isDerek/Plug_HW_MCUBoard/纸板 PHOTO/纸板 PHOTO - P18-001_Socket Sharing_v1.0 ( MCU_Board_LPC54606 )_Derek Zhu_20171227.jpg

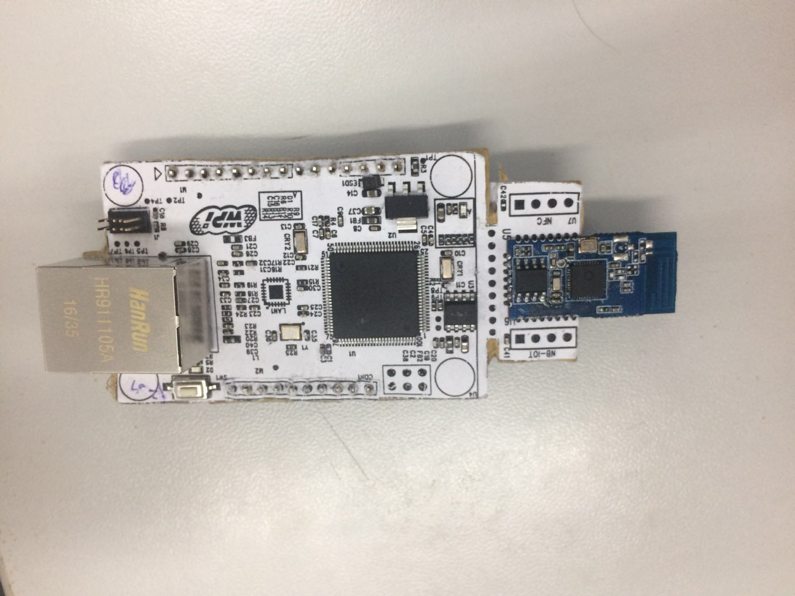
纸板 PHOTO/纸板 PHOTO - P18-001_Socket Sharing_v1.0 ( MCU_Board_LPC54606 )_Derek Zhu_20171227.jpg
