isDerek/Plug_HW_MCUBoard/方案设计 PPT/方案设计 PPT -P18-001 Oscar-Socket Sharing_v1.2_Derek Zhu_20180622.pptx

方案设计 PPT

P18-001 Socket Sharing

By Derek Zhu & Jeff Lu
2018.06.22

## Agenda

1. Version History
2. Block Diagram
3. Function Description
4. Schedule

## 1. Version History

1. 2018.02.27 - V1.0 Initial, By Derek Zhu
2. 2018.03.23 - V1.1 修改 Schedule, By Derek Zhu
3. 2018.06.22 –V1.2 修改 Schedule，By Derek Zhu

## Slide 4

2. Block Diagram – 2018.6.22

220V

交流输入

PE

N

L

继电器

Fuse

插座

16 路 IO

MCU
LPC54606

GPRS 模块

交流转直流模块

低压差线性稳压器
NCP1117ST33T3G

扩展 I2C 接口

以太网 IC
LAN8720A

5V

3.3V

网口
RJ45

JTAG
调试接口

世平提供

世平暫不提供

## Slide 5

3. Function Description – 2018.3.23

功能描述:
1. 该方案是带有联网控制，16 路 IO 控制等功能的共享插座
2. 通过以太网连接云端，可以实现微信控制插座开关和收费
3. 可以通过设备管控系统实现 OTA
4. 16 路独立过流保护

## Slide 6

4. Schedule – 2018.6.22

（1）2017.12.11 - 2017.01.21 完成 MCU Board 硬件部分
（2）2018.01.21 - 2018.02.23 调试完相关模块的驱动
（3）2018.02.26 - 2018.03.02 实现固件的基本功能
（4）2018.03.05 - 2018.04.20 完成 Power Board 硬件部分
（5）2018.04.23 - 2018.05.14 整机联调，实现 Demo 板
(6) 2018.05.15 - 2018.06.08 整机通过传导辐射
(7) 2018.06.11 - 2018.06.22 准备物料
(8) 2018.06.25 - 2018.07.06 完成第二版电源板的原理图、布局、布线
(9) 2018.07.09– 2018.07.13 完成第二版电源板的贴片、调试完 GPRS 模块

颜色说明：黑色 = On Schedule；红色 = Delay；蓝色 = 提前完成；灰色 = 待执行

## Slide 7

4. Schedule – 2018.6.11

（1） 2017.12.11 - 2017.12.25 完成 MCU 板的原理图设计及 Layout
（2） 2017.12.25 - 2018.01.07 导出 Gerber ，发出去洗板
（3） 2018.01.08 - 2017.01.21 准备物料，并做手焊 3 块板子
（4） 2018.01.21 - 2018.02.23 调试完相关模块的驱动
（5） 2018.02.26 - 2018.03.02 实现固件的基本功能
（6） 2018.03.05 - 2018.03.16 完成 Power 板的原理图设计
（7） 2018.03.19 - 2018.03.30 完成 Power 板的 Layout
（8） 2018.04.02 - 2018.04.20 发出去洗板，焊板子调试
（9） 2018.04.23 - 2018.05.14 整机联调，实现 Demo 板
（10）2018.05.15 –2018.06.08 整机通过传导辐射

颜色说明：黑色 = On Schedule；红色 = Delay；蓝色 = 提前完成；灰色 = 待执行

## Slide 8

4. Schedule – 2018.5.21

（1） 2017.12.11 - 2017.12.25 完成 MCU 板的原理图设计及 Layout
（2） 2017.12.25 - 2018.01.07 导出 Gerber ，发出去洗板
（3） 2018.01.08 - 2017.01.21 准备物料，并做手焊 3 块板子
（4） 2018.01.21 - 2018.02.23 调试完相关模块的驱动
（5） 2018.02.26 - 2018.03.02 实现固件的基本功能
（6） 2018.03.05 - 2018.03.16 完成 Power 板的原理图设计
（7） 2018.03.19 - 2018.03.30 完成 Power 板的 Layout
（8） 2018.04.02 - 2018.04.20 发出去洗板，焊板子调试
（9） 2018.04.23 - 2018.05.14 整机联调，实现 Demo 板

颜色说明：黑色 = On Schedule；红色 = Delay；蓝色 = 提前完成；灰色 = 待执行

## Slide 9

4. Schedule – 2018.4.23

（1） 2017.12.11 - 2017.12.25 完成 MCU 板的原理图设计及 Layout
（2） 2017.12.25 - 2018.01.07 导出 Gerber ，发出去洗板
（3） 2018.01.08 - 2017.01.21 准备物料，并做手焊 3 块板子
（4） 2018.01.21 - 2018.02.23 调试完相关模块的驱动
（5） 2018.02.26 - 2018.03.02 实现固件的基本功能
（6） 2018.03.05 - 2018.03.16 完成 Power 板的原理图设计
（7） 2018.03.19 - 2018.03.30 完成 Power 板的 Layout
（8） 2018.04.02 - 2018.04.20 发出去洗板，焊板子调试
（9） 2018.04.23 - 2018.05.04 整机联调，实现 Demo 板

颜色说明：黑色 = On Schedule；红色 = Delay；蓝色 = 提前完成；灰色 = 待执行

## Slide 10

4. Schedule – 2018.4.9

（1） 2017.12.11 - 2017.12.25 完成 MCU 板的原理图设计及 Layout
（2） 2017.12.25 - 2018.01.07 导出 Gerber ，发出去洗板
（3） 2018.01.08 - 2017.01.21 准备物料，并做手焊 3 块板子
（4） 2018.01.21 - 2018.02.23 调试完相关模块的驱动
（5） 2018.02.26 - 2018.03.02 实现固件的基本功能
（6） 2018.03.05 - 2018.03.16 完成 Power 板的原理图设计
（7） 2018.03.19 - 2018.03.30 完成 Power 板的 Layout
（8） 2018.04.02 - 2018.04.20 发出去洗板，焊板子调试
（9） 2018.04.23 - 2018.05.04 整机联调，实现 Demo 板

颜色说明：黑色 = On Schedule；红色 = Delay；蓝色 = 提前完成；灰色 = 待执行

## Slide 11

4. Schedule – 2018.3.23

（1） 2017.12.11 - 2017.12.25 完成 MCU 板的原理图设计及 Layout
（2） 2017.12.25 - 2018.01.07 导出 Gerber ，发出去洗板
（3） 2018.01.08 - 2017.01.21 准备物料，并做手焊 3 块板子
（4） 2018.01.21 - 2018.02.23 调试完相关模块的驱动
（5） 2018.02.26 - 2018.03.02 实现固件的基本功能
（6） 2018.03.05 - 2018.03.16 完成 Power 板的原理图设计
（7） 2018.03.19 - 2018.03.30 完成 Power 板的 Layout
（8） 2018.04.02 - 2018.04.20 发出去洗板，焊板子调试
（9） 2018.04.23 - 2018.05.04 整机联调，实现 Demo 板

颜色说明：黑色 = On Schedule；红色 = Delay；蓝色 = 提前完成；灰色 = 待执行

## Slide 12

4. Schedule – 2018.2.27

（1） 2017.12.11 - 2017.12.25 完成 MCU 板的原理图设计及 Layout
（2） 2017.12.25 - 2018.01.07 导出 Gerber ，发出去洗板
（3） 2018.01.08 - 2017.01.21 准备物料，并做手焊 3 块板子
（4） 2018.01.21 - 2018.01.30 完成 MCU 板的调试
（5） 2018.01.31 - 2018.02.23 完成相关驱动调试
（6） 2018.02.26 - 2018.03.02 完成固件基本功能
（7） 2018.03.05 - 2018.03.23 完成 Power 板的原理图设计及 Layout
（8） 2018.03.26 - 2018.04.06 调试完成 OTA 升级功能
（9） 2018.04.09 – 2018.04.27 整机联调，实现 Demo 板

颜色说明：黑色 = On Schedule；红色 = Delay；蓝色 = 提前完成；灰色 = 待执行

## Slide 13

World Peace Confidential
