isDerek/Plug_HW_MCUBoard/BOM 表/BOM -P18-001 Socket Sharing_v1.0 ( MCU_Board_LPC54606 )_Derek Zhu_20171227.xlsx

1.序號 | 2.用量 | 3.元件位置編號 | 4.型號/元件值 | 5. 物料型态 | 6.特徵-1 ( 封裝 ) | 7.特徵-2 | 8.特徵-3 | 9.特徵-4 | NULL | 11.廠牌 | 12.供應商 | 13.數據手冊檔案名稱(規格書)
1. Item | 2. Quantity | 3. Reference | 4. Part Number /Value | 5. Device Type | 6. Feature-1 (Package) | 7. Feature-2 | 8. Feature-3 | 9. Feature-4 | 10. Feature-5 | 11. Brand | 12. Supplier | 13. Datasheet File Name
1 | 1 | L1 | BLM18PG181SN1 | Connector | R0603 | NULL | NULL | NULL | NULL | TBD | Unknow | TBD
2 | 1 | U4 | BLOCK | Connector | 1x40 2.54MM | NULL | NULL | NULL | NULL | TBD | Unknow | TBD
3 | 4 | C1-2 C4 C6 | 0.01uF | Capacitor | C0402 | NULL | NULL | NULL | NULL | TBD | Unknow | TBD
4 | 20 | C3 C5 C7-9 C16-19 C22-23 C26 C27 C30 C38-41 | 0.1uF | Capacitor | C0402 | NULL | NULL | NULL | NULL | TBD | Unknow | TBD
5 |  | C28 C29 | 1nF | Capacitor | C0402 | NULL | NULL | NULL | NULL | TBD | Unknow | TBD
6 | 1 | C21 | 10uF | Capacitor | C0402 | NULL | NULL | NULL | NULL | TBD | Unknow | TBD
7 | 3 | C14-15 C37 | 10uF | Capacitor | C0603 | NULL | NULL | NULL | NULL | TBD | Unknow | TBD
8 | 4 | C31-34 | 18pF | Capacitor | C0402 | NULL | NULL | NULL | NULL | TBD | Unknow | TBD
9 | 2 | C12-13 | 18pF/50V/5% | Capacitor | C0402 | 50V | ±5% | NULL | NULL | TBD | Unknow | TBD
10 | 1 | C25 | 1uF/10V | Capacitor | C0402 | 10V | NULL | NULL | NULL | TBD | Unknow | TBD
11 | 4 | C10-11 C35-36 | 27pF | Capacitor | C0402 | 25V | NULL | NULL | NULL | TBD | Unknow | TBD
12 | 1 | C20 | 4.7uF | Capacitor | C0603 | 25V | NULL | NULL | NULL | TBD | Unknow | TBD
13 | 1 | C24 | 470pF | Capacitor | C0402 | 25V | NULL | NULL | NULL | TBD | Unknow | TBD
14 | 1 | CRY1 | 12MHz | CRYSTAL | CRY3215 | 25V | NULL | NULL | NULL | TBD | Unknow | TBD
15 | 1 | CRY2 | 32.768KHz | CRYSTAL | CRY3215 | 25V | NULL | NULL | NULL | TBD | Unknow | TBD
16 | 1 | FB1 FB3 | FB1,600 OHM | Ferrite Bead | R0603 | 25V | NULL | NULL | NULL | TBD | Unknow | TBD
17 | 1 | FB2 | FB2,600ohm | Ferrite Bead | R0603 | 25V | NULL | NULL | NULL | TBD | Unknow | TBD
18 | 1 | U3 | GT24C02A | EEPROM | SOP-8 | 25V | NULL | NULL | NULL | TBD | Unknow | TBD
19 | 1 | J1 | HDR_2X5 | Connector | HDR_2X5_1.27MM | NULL | NULL | NULL | NULL | TBD | Unknow | TBD
20 | 1 | RJ1 | HR911105A | HR911105A | HR911105A | NULL | NULL | NULL | NULL | TBD | Unknow | TBD
21 | 1 | LAN1 | LAN8720A-CP | RJ45 | QFN_24PIN_4X4_0.5 | NULL | NULL | NULL | NULL | TBD | Unknow | TBD
22 | 2 | D1-2 | LED | LED | LED0603 | NULL | NULL | NULL | NULL | TBD | Unknow | TBD
23 | 1 | CON1 | MCU_EX_PORT_2X3 | Connector | 2X3_2.54MM | NULL | NULL | NULL | NULL | TBD | Unknow | TBD
24 | 2 | U6、U7 | NB_IOT | Connector | 1X4_2.54MM | NULL | NULL | NULL | NULL | TBD | Unknow | TBD
25 | 1 | U2 | NCP11173T33T3 | LDO | SOT223 | 3.3V | NULL | NULL | NULL | TBD | Unknow | TBD
26 | 1 | R15 | 1.5K | Resistance | R0402 | NULL | NULL | NULL | NULL | TBD | Unknow | TBD
27 | 1 | R4 | 100K | Resistance | R0402 | NULL | NULL | NULL | NULL | TBD | Unknow | TBD
28 | 1 | R7 | 100R | Resistance | R0402 | NULL | NULL | NULL | NULL | TBD | Unknow | TBD
29 | 3 | R1-2 R8 | 10K | Resistance | R0402 | NULL | NULL | NULL | NULL | TBD | Unknow | TBD
30 | 2 | R23-24 | 12.1K | Resistance | R0402 | NULL | NULL | NULL | NULL | TBD | Unknow | TBD
31 | 1 | R25 | 1M | Resistance | R0402 | NULL | NULL | NULL | NULL | TBD | Unknow | TBD
32 | 1 | R5 | 2.2K | Resistance | R0402 | NULL | NULL | NULL | NULL | TBD | Unknow | TBD
33 | 1 | R21 | 510R | Resistance | R0402 | NULL | NULL | NULL | NULL | TBD | Unknow | TBD
34 | 4 | R6 R9 R11 R13 | 4.7K | Resistance | R0402 | NULL | NULL | NULL | NULL | TBD | Unknow | TBD
35 | 4 | R16-19 | 49.9R | Resistance | R0402 | NULL | NULL | NULL | NULL | TBD | Unknow | TBD
36 | 2 | R20 R22 | 510R | Resistance | R0402 | NULL | NULL | NULL | NULL | TBD | Unknow | TBD
37 | 1 | R3 | NC/0R | Resistance | R0603 | NULL | NULL | NULL | NULL | TBD | Unknow | TBD
38 | 3 | R10 R12 R14 | NC/0R | Resistance | R0402 | NULL | NULL | NULL | NULL | TBD | Unknow | TBD
39 | 1 | ESD1 | SMF6V0A1 | ESD_Diode | SMF | NULL | NULL | NULL | NULL | TBD | Unknow | TBD
40 | 1 | SW1 | SW2_STM151XX | Switch | Switch | NULL | NULL | NULL | NULL | TBD | Unknow | TBD
41 | 9 | TP1-9 | TEST_POINT | TEST_POINT | TEST_POINT | NULL | NULL | NULL | NULL | TBD | Unknow | TBD
42 | 1 | U1 | LPC54606J256BD100E | IC | LPC54606_100PIN | NULL | NULL | NULL | NULL | TBD | Unknow | TBD
43 | 1 | Y1 | 25MHZ | CRYSTAL | CRY3225 | NULL | NULL | NULL | NULL | TBD | Unknow | TBD
