isDerek/Plug_HW_MCUBoard/PCB PDF/PCB - PDF - P18-001 Socket Sharing_v1.1 ( MCU_Board_LPC54606 )_Derek Zhu_20181127.pdf

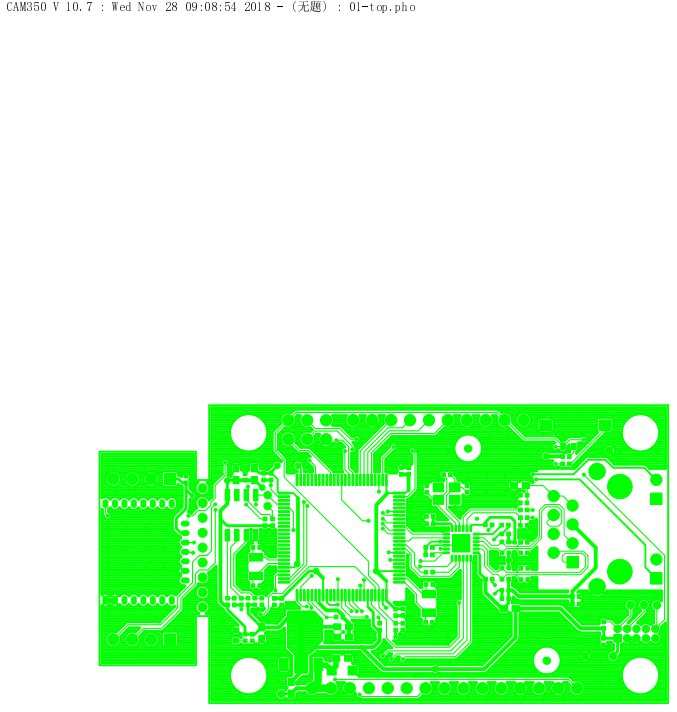
[picture p4: page 1]

CAM350 V 10.7 : Wed Nov 28 09:08:54 2018 - (无题) : 01-top.pho

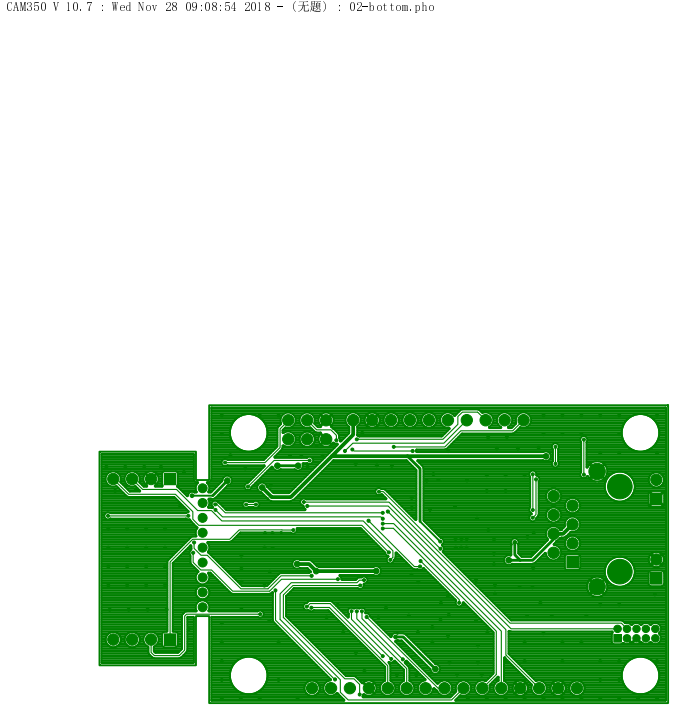
[picture p5: page 2]

CAM350 V 10.7 : Wed Nov 28 09:08:54 2018 - (无题) : 02-bottom.pho

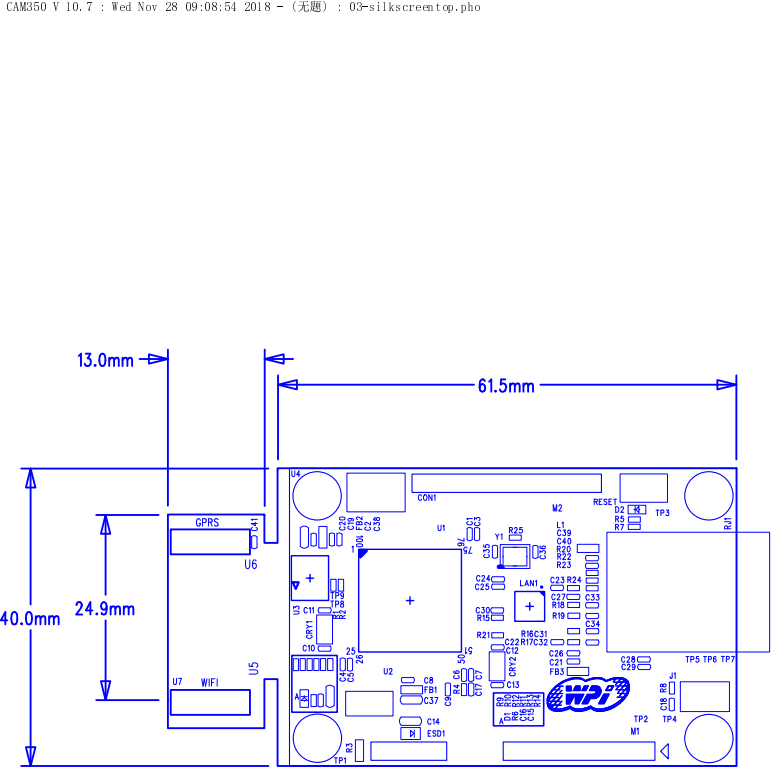
[picture p6: page 3]

CAM350 V 10.7 : Wed Nov 28 09:08:54 2018 - (无题) : 03-silkscreentop.pho

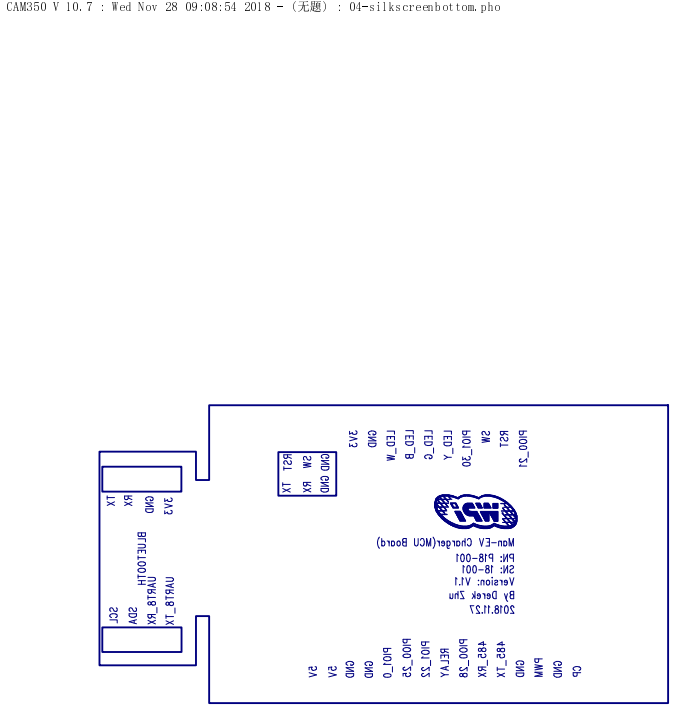
[picture p7: page 4]

CAM350 V 10.7 : Wed Nov 28 09:08:54 2018 - (无题) : 04-silkscreenbottom.pho

CAM350 V 10.7 : Wed Nov 28 09:08:54 2018 - (无题) : 05-pastetop.pho

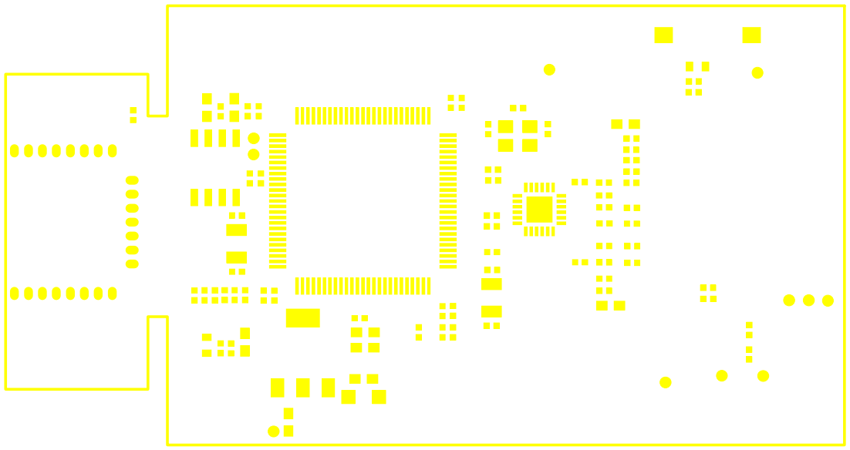
[picture p8: figure]

CAM350 V 10.7 : Wed Nov 28 09:08:54 2018 - (无题) : 06-pastebottom.pho

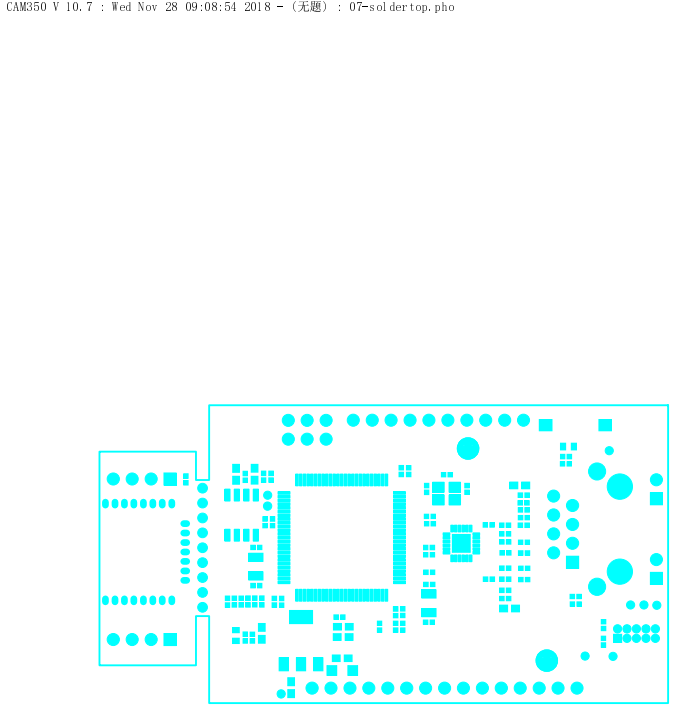
[picture p9: page 7]

CAM350 V 10.7 : Wed Nov 28 09:08:54 2018 - (无题) : 07-soldertop.pho

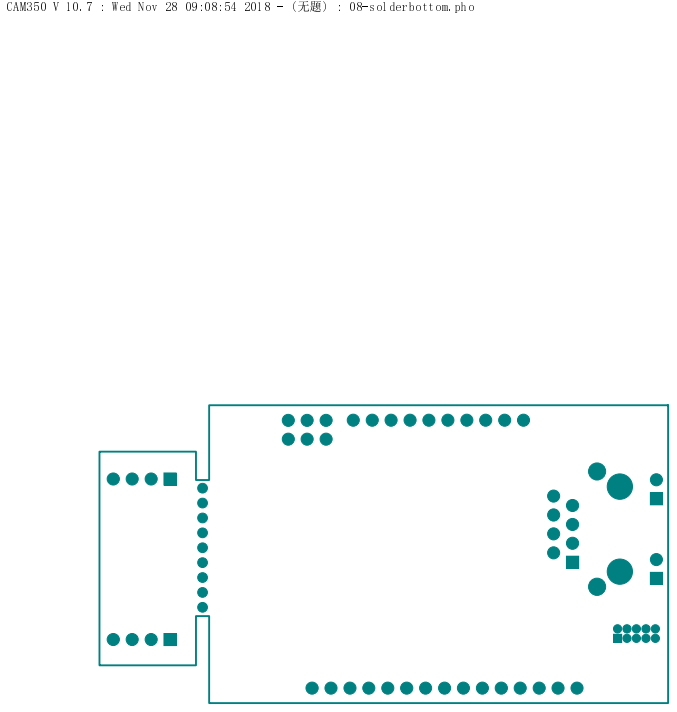
[picture p10: page 8]

CAM350 V 10.7 : Wed Nov 28 09:08:54 2018 - (无题) : 08-solderbottom.pho

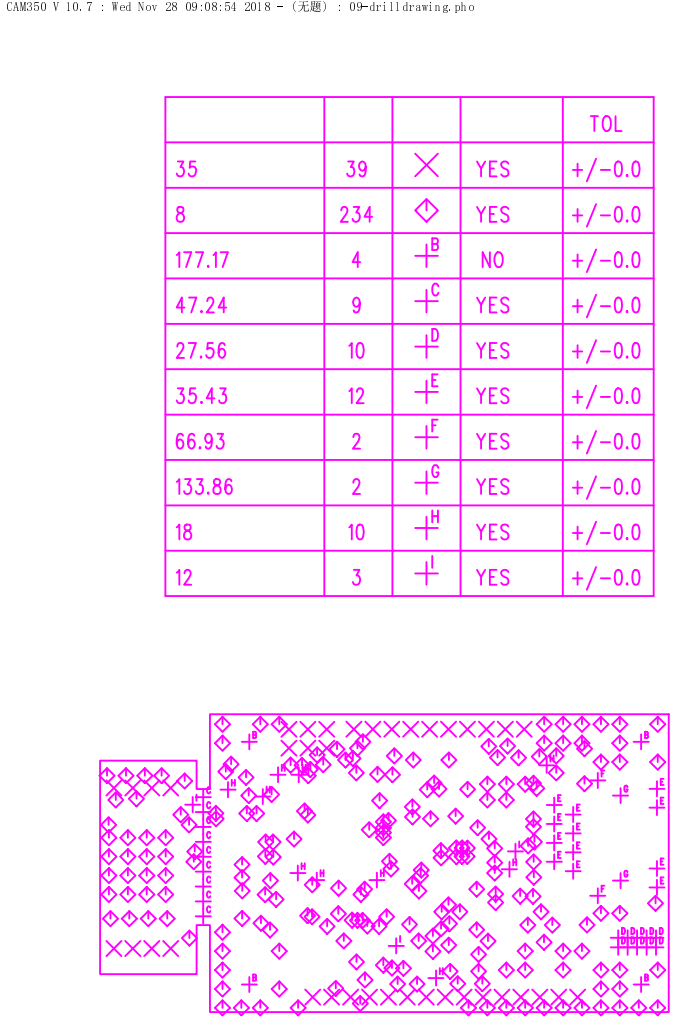
[picture p11: page 9]

CAM350 V 10.7 : Wed Nov 28 09:08:54 2018 - (无题) : 09-drilldrawing.pho

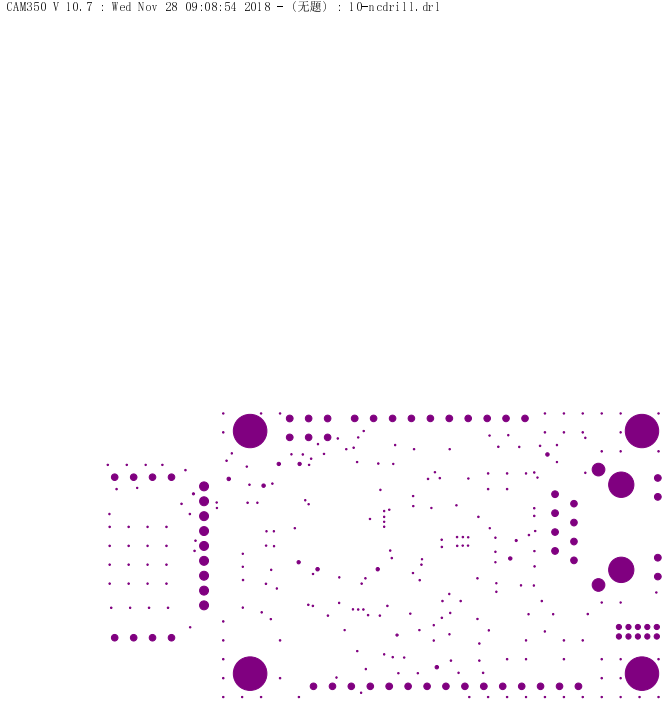
[picture p12: page 10]

CAM350 V 10.7 : Wed Nov 28 09:08:54 2018 - (无题) : 10-ncdrill.drl
