isDerek/Plug_HW_MCUBoard/PCB 位号图 更新/PCB - P18-001 Socket Sharing_v1.1 ( MCU_Board_LPC54606 )_Derek Zhu_20181127.pdf

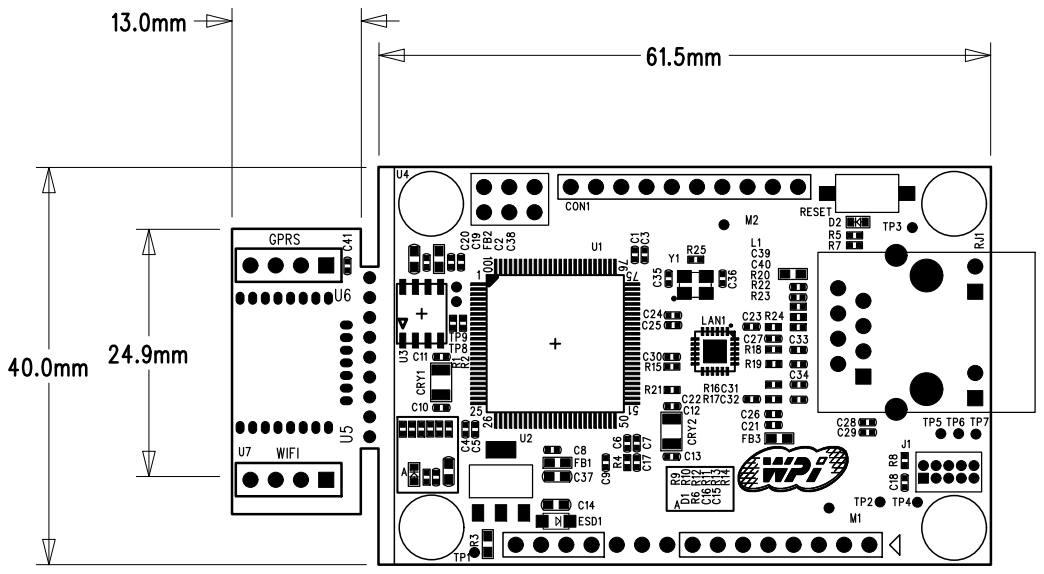
[picture p13: page 1]

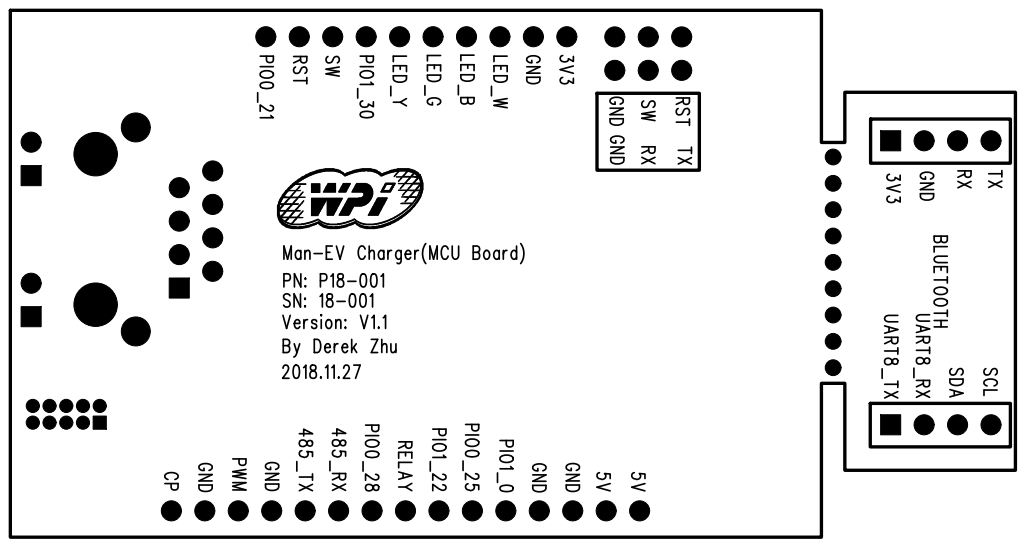
[picture p14: page 2]
BLUETOOTH; PIO0_21; RST; PIO1_30; LED_Y; LED_G; LED_B; LED_W; GND; PWM; PIO0_28; RELAY; PIO1_22; PIO0_25; PIO1_0; UART8_TX; UART8_RX; SDA; SCL; TX CON1x1 CON1 CON1x2 CON1x3 CON1x4 CON1x5 CON1x6

Man-EV Charger(MCU Board)
Version: V1.1
By Derek Zhu
