isDerek/Plug_HW_MCUBoard/SCH PDF 更新/SCH - P18-001 Socket Sharing_v1.1 ( MCU_Board_LPC54606 )_Derek Zhu_20181127.pdf

D

6 | 5 | 4 | 3 | 2 | 1

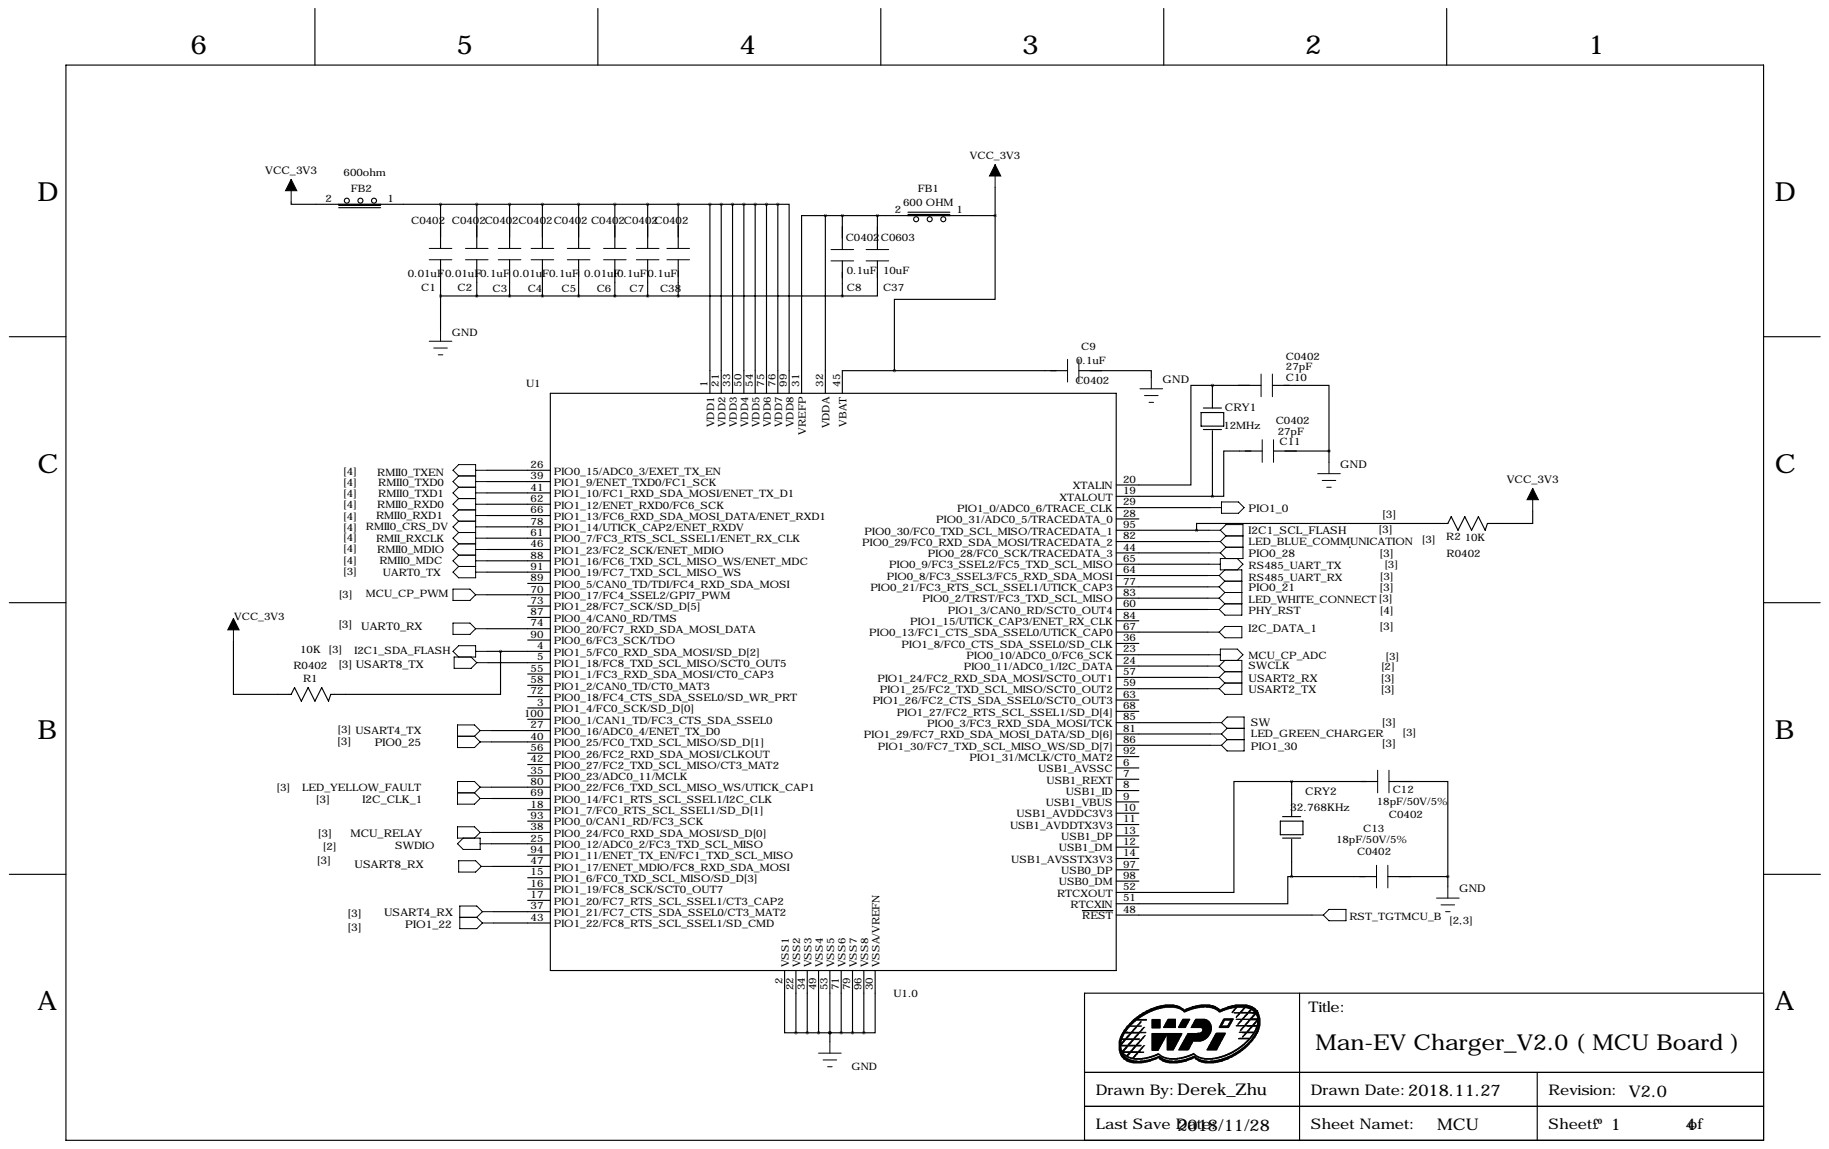
[picture p15: page 1]

Title: Man-EV Charger_V2.0 ( MCU Board )

Drawn By: Derek_Zhu | Drawn Date: 2018.11.27 | Revision: V2.0

Last Save Date: 2018/11/28 | Sheet Namet: MCU | Sheet£º 1 4 of

D

6 | 5 | 4 | 3 | 2 | 1

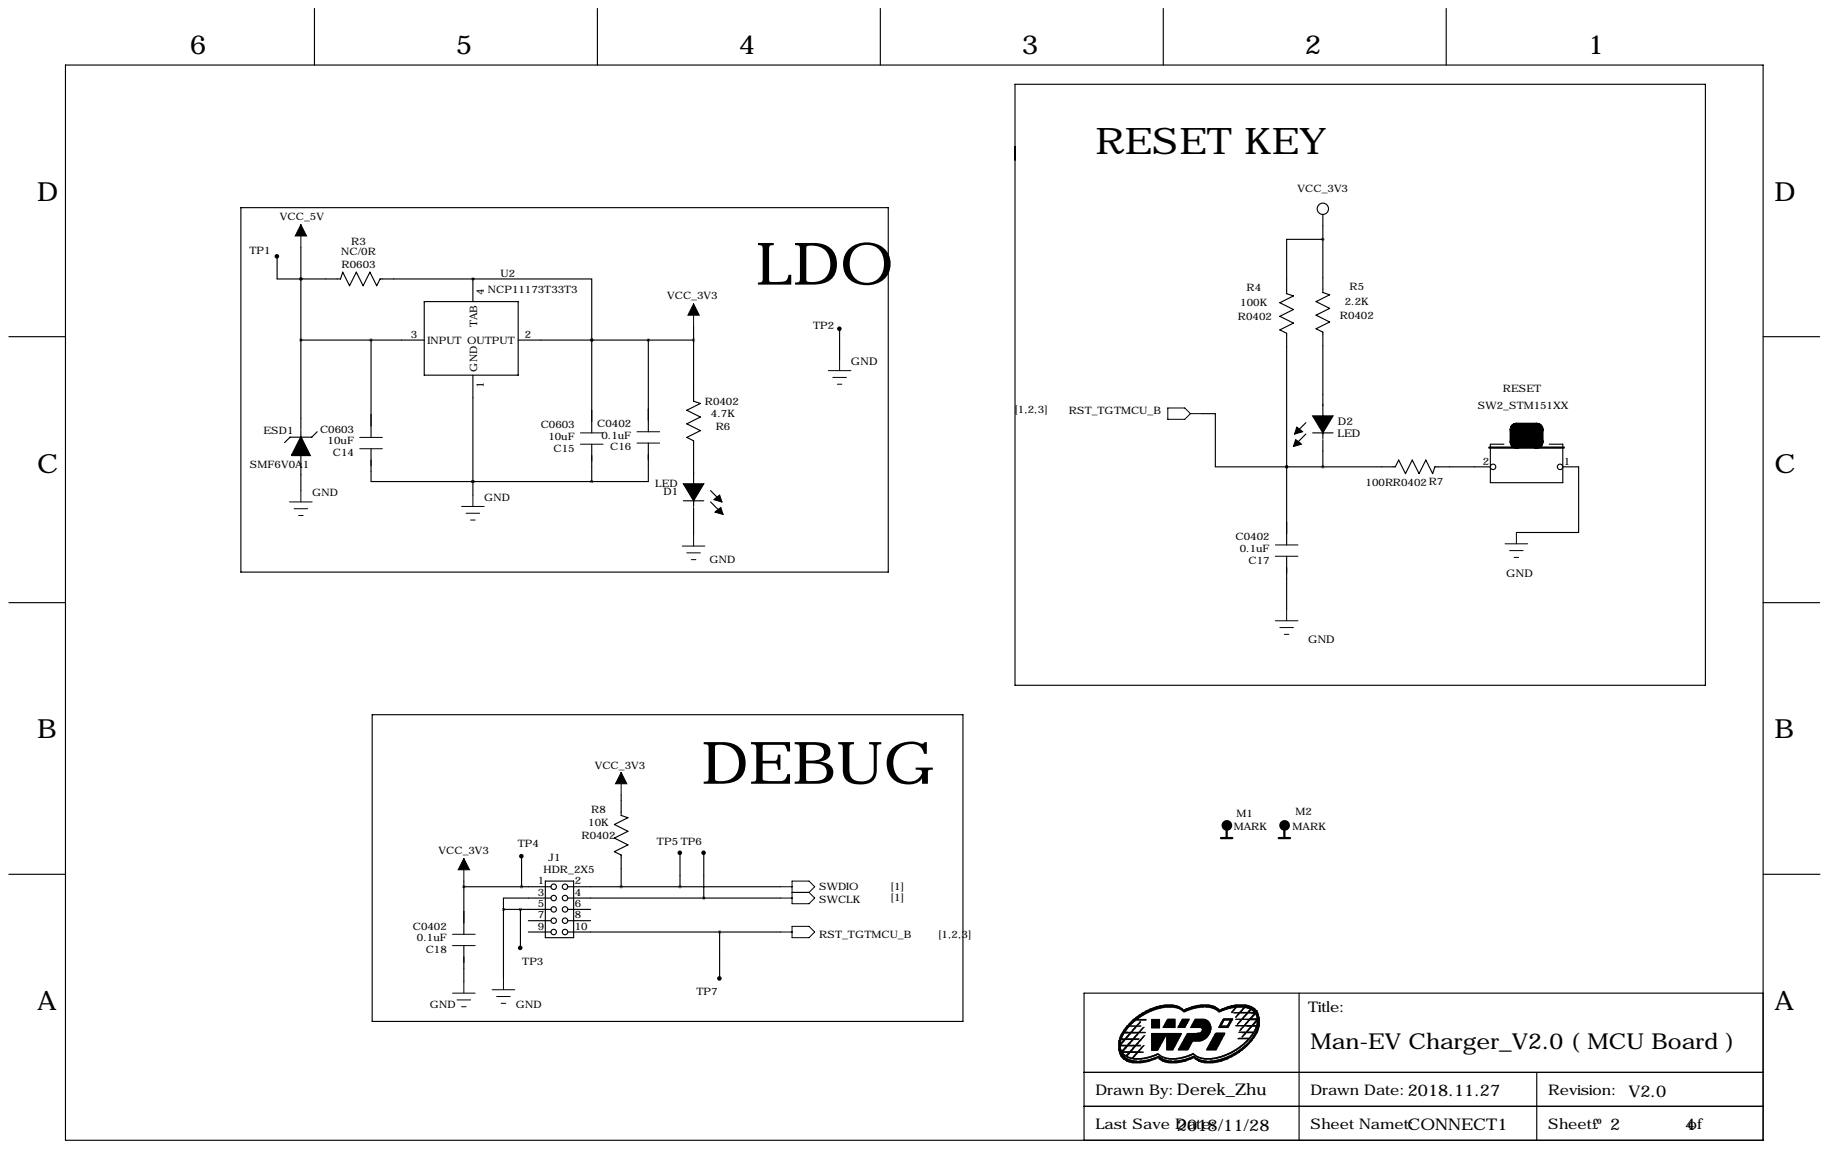
[picture p16: page 2]

Title: Man-EV Charger_V2.0 ( MCU Board )

Derek_Zhu Drawn By: | 2018.11.27 Drawn Date: | Revision: V2.0

Last Save Date: 2018/11/28 | Sheet Namet:CONNECT1 | Sheet£º 2 4 of

D

6 | 5 | 4 | 3 | 2 | 1

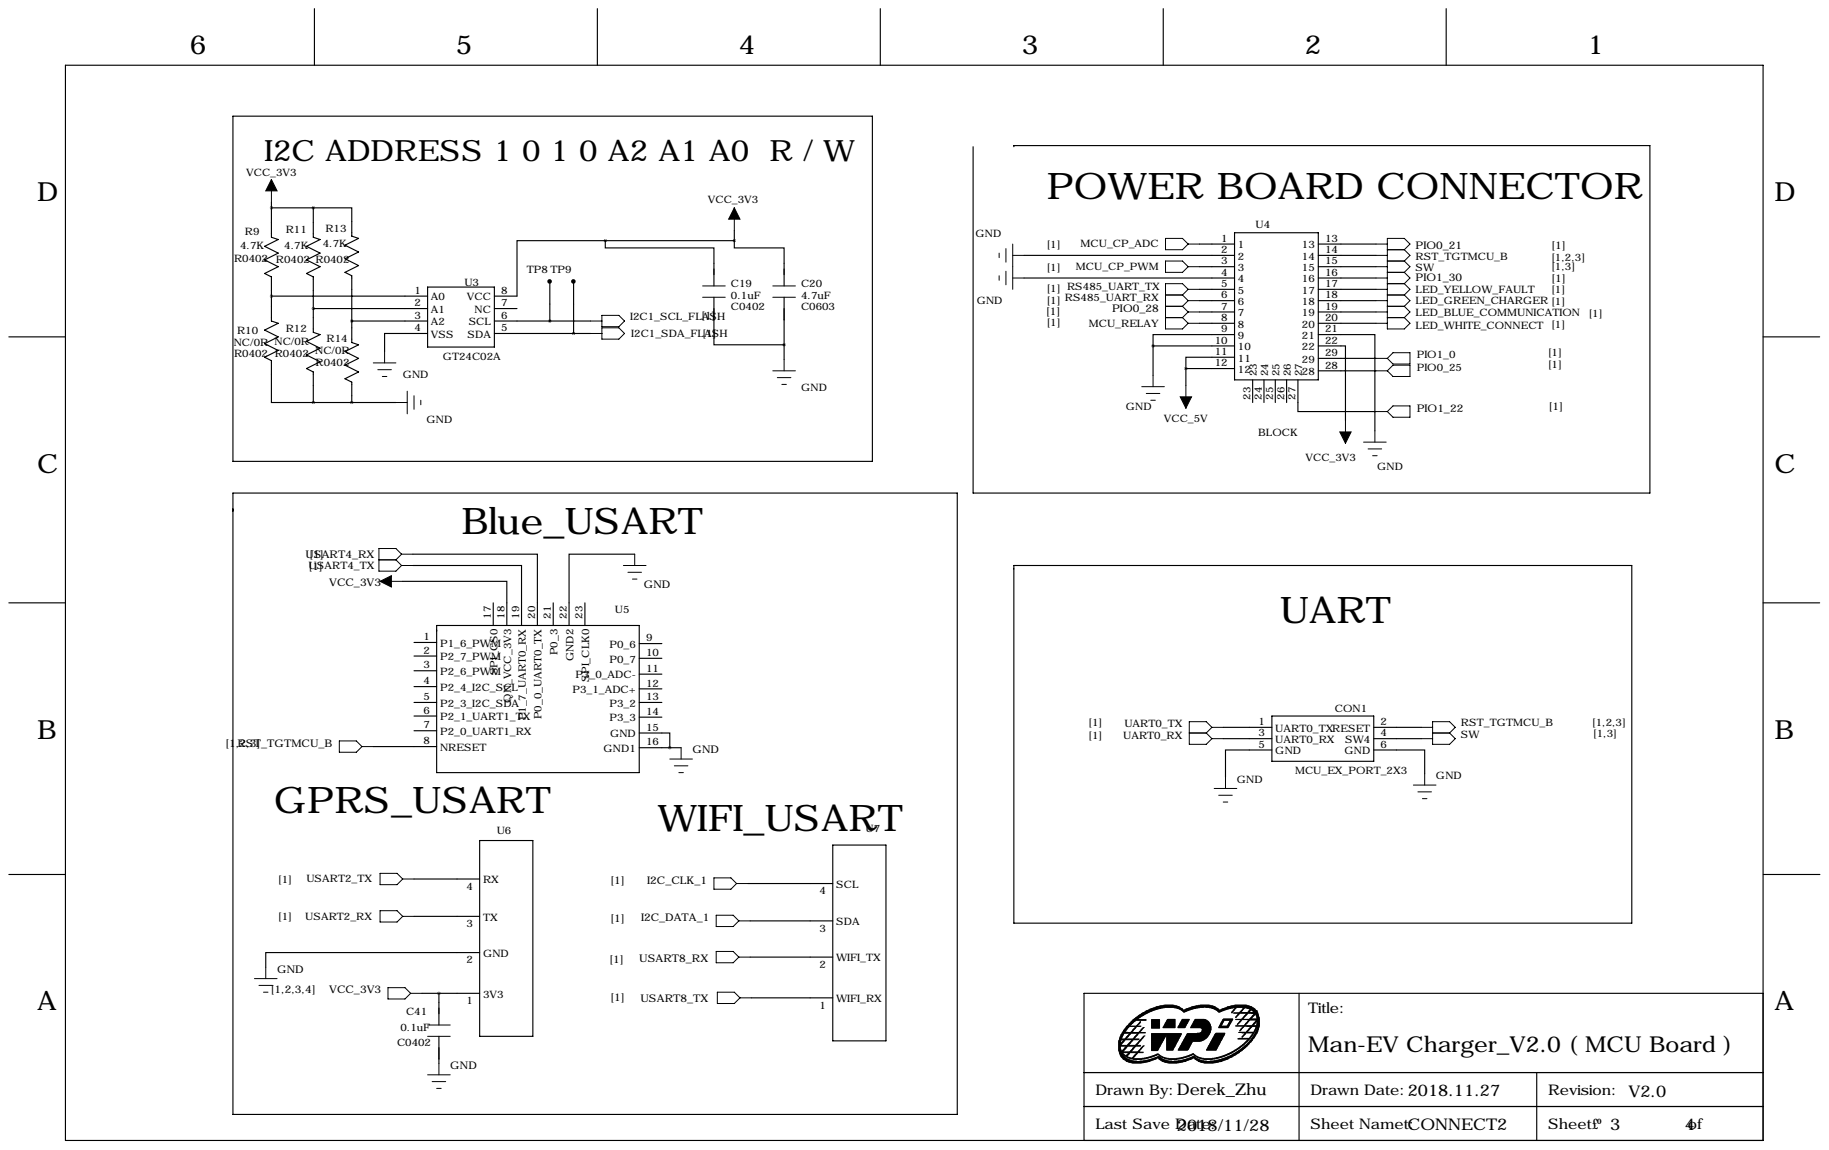
[picture p17: page 3]

Title: Man-EV Charger_V2.0 ( MCU Board )

Derek_Zhu Drawn By: | 2018.11.27 Drawn Date: | V2.0 Revision:

Last Save Date: 2018/11/28 | Sheet Namet:CONNECT2 | Sheet£º 3 4 of

D

6 | 5 | 4 | 3 | 2 | 1

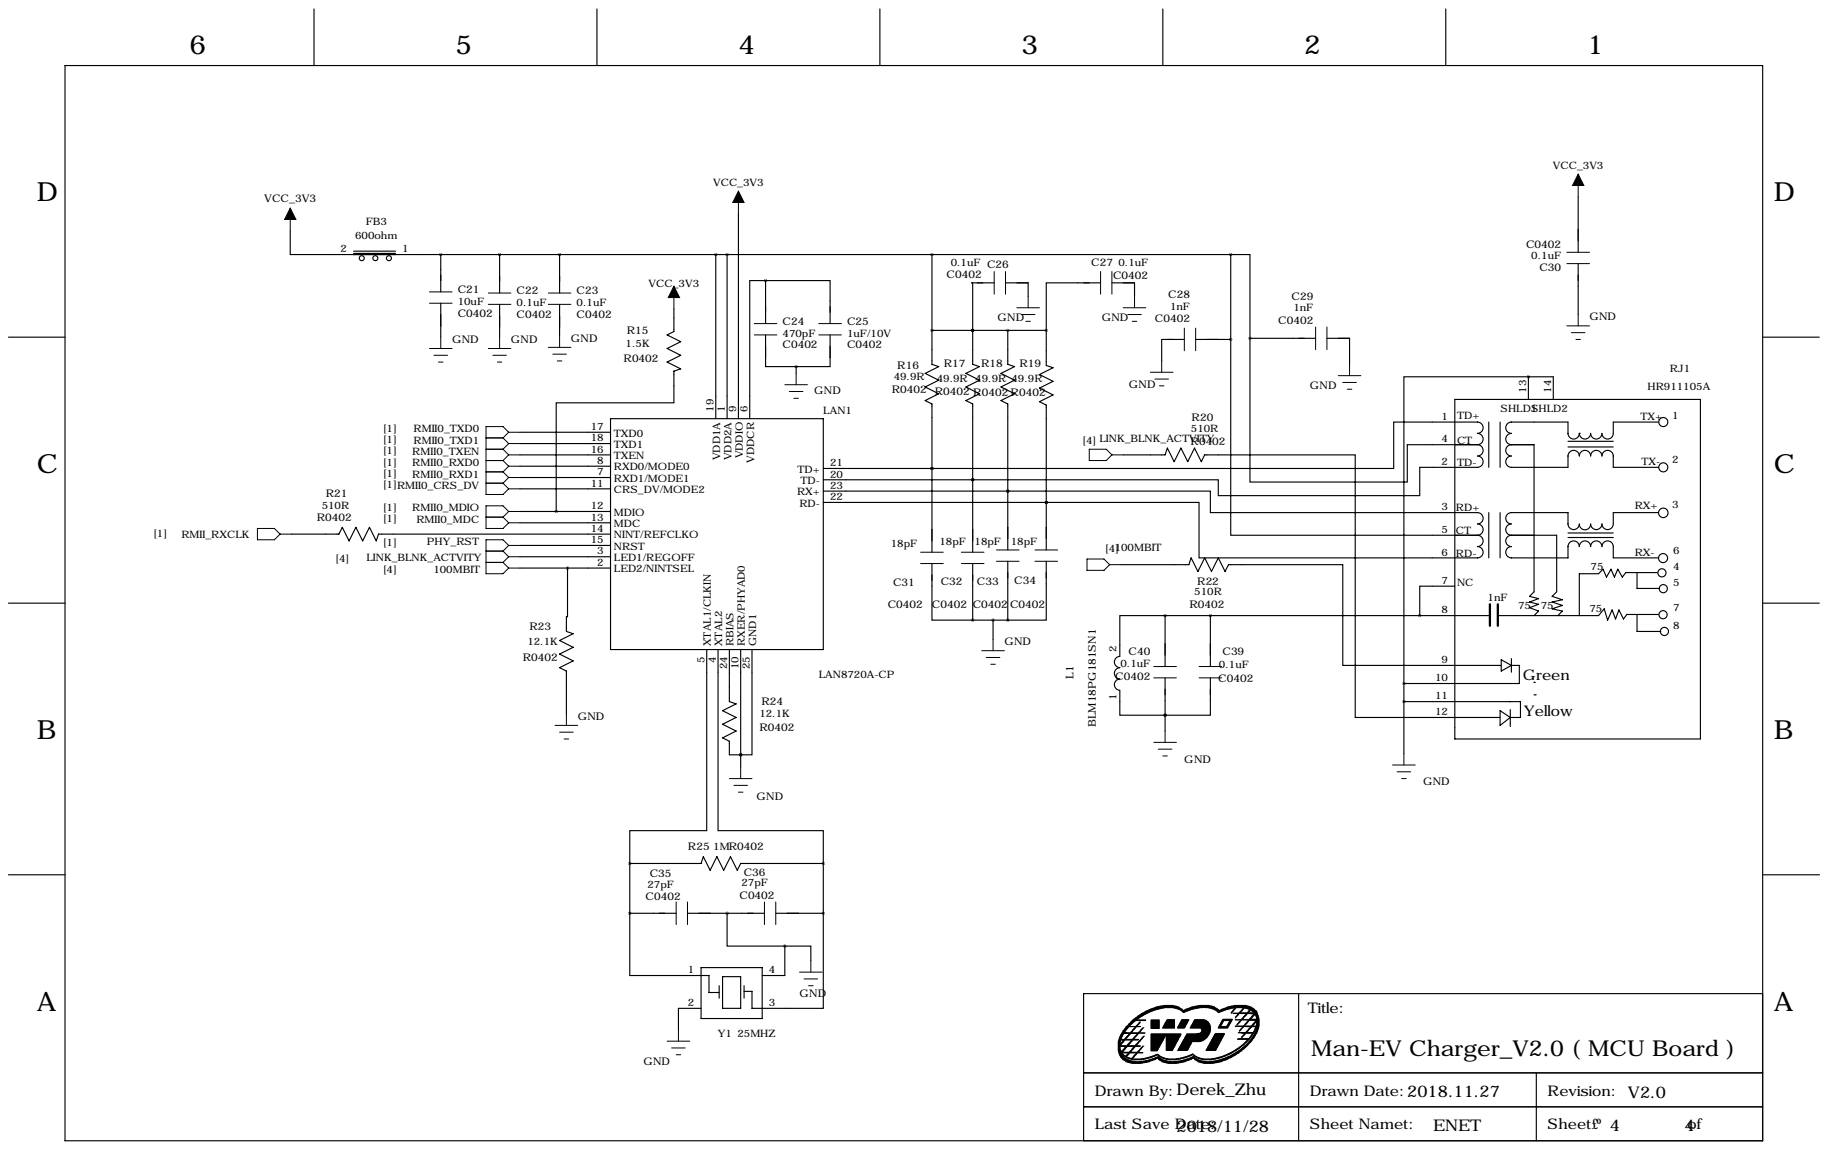
[picture p18: page 4]

VCC_3V3

SHLD1 | SHLD2

10

Title: Man-EV Charger_V2.0 ( MCU Board )

Drawn By: Derek_Zhu | Drawn Date: 2018.11.27 | Revision: V2.0

Last Save Date: 2018/11/28 | Sheet Namet: ENET | Sheet£º 4 4 of
