isDerek/Plug_HW_MCUBoard/(list of files, drawings)

Other design files:
PCB Layout 更新/PCB - P18-001 Socket Sharing_v1.1 ( MCU_Board_LPC54606 )_Derek Zhu_20181127.pcb
