isDerek/Plug_HW_MCUBoard/(commit log)

2018-11-27 完成了共享插座控制板硬件
    [BOM -P18-001 Socket Sharing_v1.0 ( MCU_Board_LPC54606 )_Derek Zhu_20171227.xlsx, PCB - P18-001 Socket Sharing_v2.0 ( MCU_Board_LPC54606 )_Derek Zhu_20181127.pcb, SCH - P18-001 Socket Sharing_v2.0 ( MCU_Board_LPC54606 )_Derek Zhu_20181127.sch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]
2018-11-28 修改了原理图的 BUG，修改了底部的水印，检查了 gerber
    [PCB - P18-001 Socket Sharing_v1.1 ( MCU_Board_LPC54606 )_Derek Zhu_20181127.pcb, PCB - P18-001 Socket Sharing_v2.0 ( MCU_Board_LPC54606 )_Derek Zhu_20181127.pcb, SCH - P18-001 Socket Sharing_v1.1 ( MCU_Board_LPC54606 )_Derek Zhu_20181127.sch, SCH - P18-001 Socket Sharing_v2.0 ( MCU_Board_LPC54606 )_Derek Zhu_20181127.sch]
